55joe/A-five-stage-pipelined-CPU-based-on-MIPS/repository/_0.xdc

set_property -dict {PACKAGE_PIN R4 IOSTANDARD LVCMOS33} [get_ports {clk}]
set_property -dict {PACKAGE_PIN B21 IOSTANDARD LVCMOS33} [get_ports {rst}]

set_property -dict {PACKAGE_PIN N2 IOSTANDARD LVCMOS33} [get_ports {leds[0]}]
set_property -dict {PACKAGE_PIN P5 IOSTANDARD LVCMOS33} [get_ports {leds[1]}]
set_property -dict {PACKAGE_PIN V5 IOSTANDARD LVCMOS33} [get_ports {leds[2]}]
set_property -dict {PACKAGE_PIN U5 IOSTANDARD LVCMOS33} [get_ports {leds[3]}]
set_property -dict {PACKAGE_PIN T5 IOSTANDARD LVCMOS33} [get_ports {leds[4]}]
set_property -dict {PACKAGE_PIN P1 IOSTANDARD LVCMOS33} [get_ports {leds[5]}]
set_property -dict {PACKAGE_PIN W4 IOSTANDARD LVCMOS33} [get_ports {leds[6]}]

set_property -dict {PACKAGE_PIN Y3 IOSTANDARD LVCMOS33} [get_ports {an[0]}]
set_property -dict {PACKAGE_PIN R1 IOSTANDARD LVCMOS33} [get_ports {an[1]}]
set_property -dict {PACKAGE_PIN P2 IOSTANDARD LVCMOS33} [get_ports {an[2]}]
set_property -dict {PACKAGE_PIN M2 IOSTANDARD LVCMOS33} [get_ports {an[3]}]

set_property CLOCK_DEDICATED_ROUTE FALSE [get_nets {clk_IBUF}]
create_clock -period 10.000 -name clk -waveform {0.000 5.000} [get_ports clk]
