55joe/A-five-stage-pipelined-CPU-based-on-MIPS/repository/_0InstructionMemory.v

module _0InstructionMemory(
	input      [32 -1:0] Address, 
	output reg [32 -1:0] Instruction
);
	
	initial
		Instruction = 32'b0;

	always @(*)
		case (Address[10:2])
/*
9'd0:  Instruction <= 32'b00100000000111010000001000000000;
9'd1:  Instruction <= 32'b00100000000100000000000000000001;
9'd2:  Instruction <= 32'b10001100000001010000000000000000;
9'd3:  Instruction <= 32'b00100000000001000000000000000100;
9'd4:  Instruction <= 32'b00001100000100000000000001000010;
9'd5:  Instruction <= 32'b00000000000000000000000000000000;
9'd6:  Instruction <= 32'b00001000000100000000000001010011;
9'd7:  Instruction <= 32'b00000000000000000000000000000000;
9'd8:  Instruction <= 32'b00100000000000010000000000000100;
9'd9:  Instruction <= 32'b00000011101000011110100000100010;
9'd10: Instruction <= 32'b10101111101111110000000000000000;
9'd11: Instruction <= 32'b00000001000000000100100000100000;
9'd12: Instruction <= 32'b00100000000000010000000000000001;
9'd13: Instruction <= 32'b00000001001000010100100000100010;
9'd14: Instruction <= 32'b00000001000000000101000000100000;
9'd15: Instruction <= 32'b00000000000010100101000010000000;
9'd16: Instruction <= 32'b00000000100010101100000000100000;
9'd17: Instruction <= 32'b10001111000010110000000000000000;
9'd18: Instruction <= 32'b00100010000100000000000000000001;
9'd19: Instruction <= 32'b00000001001000000101000000100000;
9'd20: Instruction <= 32'b00000000000010100101000010000000;
9'd21: Instruction <= 32'b00000000100010101100000000100000;
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
9'd339: Instruction <= 32'h0810016b;
9'd340: Instruction <= 32'h00000000;
9'd341: Instruction <= 32'h20010001;
9'd342: Instruction <= 32'h01c17022;
9'd343: Instruction <= 32'h15c0000c;
9'd344: Instruction <= 32'h00000000;
9'd345: Instruction <= 32'h20010001;
9'd346: Instruction <= 32'h01c17022;
9'd347: Instruction <= 32'h20100001;
9'd348: Instruction <= 32'h20110000;
9'd349: Instruction <= 32'h20120000;
9'd350: Instruction <= 32'h20130000;
9'd351: Instruction <= 32'h20140001;
9'd352: Instruction <= 32'h20150001;
9'd353: Instruction <= 32'h20160001;
9'd354: Instruction <= 32'h0810016b;
9'd355: Instruction <= 32'h00000000;
9'd356: Instruction <= 32'h20100000;
9'd357: Instruction <= 32'h20110000;
9'd358: Instruction <= 32'h20120000;
9'd359: Instruction <= 32'h20130000;
9'd360: Instruction <= 32'h20140000;
9'd361: Instruction <= 32'h20150000;
9'd362: Instruction <= 32'h20160000;
9'd363: Instruction <= 32'h8fbf0000;
9'd364: Instruction <= 32'h23bd0004;
9'd365: Instruction <= 32'h03e00008;
9'd366: Instruction <= 32'h00000000;




default:Instruction <= 32'b0;


		endcase
		
endmodule
