55joe/A-five-stage-pipelined-CPU-based-on-MIPS/repository/_5WB.v

`timescale 1ns / 1ps
//////////////////////////////////////////////////////////////////////////////////
// Module Name: _5WB
// Description: 
//////////////////////////////////////////////////////////////////////////////////


module _5WB(

    );
endmodule
